SuperLeaf8/mobile-cardiac-sensor/README.md

# Mobile "Cardiac" Sensor
it does NOT detect a cardiac signature, it detects up to 3 human targets and tracks them as best as it can.

this works by using a radar "echo", kind of like ultrasonic except high frequency RF instead of ultrasonic sound waves. it tries its best to pick up flesh like objects like that and determine distances

if you built this correctly, you will see a radar type display with some text. targets will show up as differently colored dots
by default the range i set is 5m, each line in the circle is 1m
the bigger the dots are, the more you can suspect a cluster of people

do look at the [documentation](https://github.com/SuperLeaf8/mobile-cardiac-sensor/blob/main/457502695.pdf)

## hi, some things to note
1. if you want to make your own version with different parts or rewritten code (making it better or making it do different things) you can make forks, and do let me know i am very interested in seeing
2. this is using consumer grade electronics because i am a poor engineering student. the not so dependent quality is the irl nerf
3. i expect you to at least know how to connect wires together and use a computer. be a LITTLE tech savvy, i will try to explain how and why i do things
4. the 3d files are for if you are using the components i used EXACTLY. if not, you can use tinkercad to tinker with the 3d models.
5. if you have questions you can leave an issue with a question label

## materials
you will NEED the following:
- [RD03D sensor (the tracking thing)](https://a.co/d/0ip2m8Sf)
- [4" TFT screen (display)](https://a.co/d/0evdUtjt) or other 320x480 tft display, make sure it is ST7796S driven. otherwise youll have new wirings and new code to make
- [TXB/S0108 board](https://a.co/d/0fWlWtSx)
- [3.7v LiPo](https://a.co/d/0aEmB9fg)
- [charging board for battery](https://a.co/d/0h1k8oPG)
- a 5v microcontroller + programming board/cable. i am using the Arduino Pro Mini (5V, 16MHz) but i recommend an Arduino Nano if you dont mind using more space
- computer to upload program
### other matierals/tools you need not specific to the project
- soldering station (preferably a station, not those cheap cord ones). should come with solder wire and flux
- green prototype circuit boards with holes
- wires for the pcb

if you are NOT using a microcontroller that has 3.3v (arduino pro mini 5v for example), you will need the [3.3v regulator](https://a.co/d/0eNMOGoz)
if your board has a 3.3v regulator (like the nano) then use that instead

## how to make (the hardware)
i will upload a picture and link the circuit to refer to in order to build the hardware for this. i HIGHLY suggest soldering a circuit, and even more suggest getting a proper PCB from a vendor. soldering skills are a must

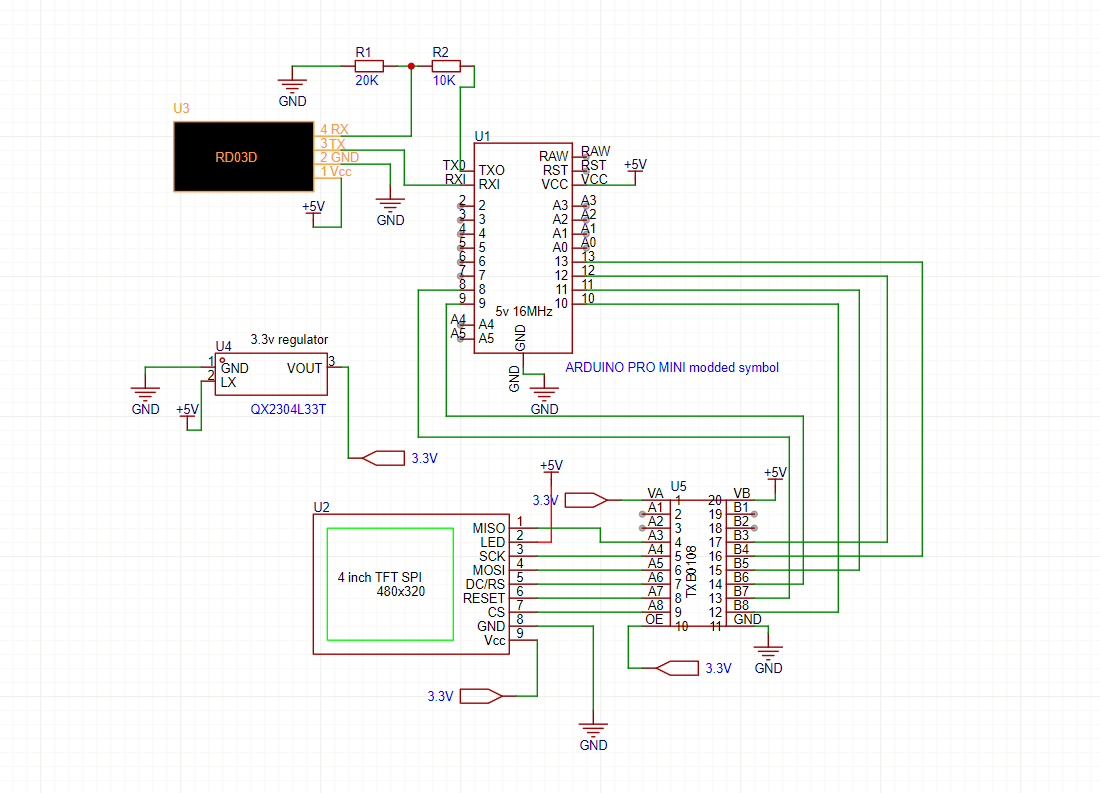
[picture p1: schematic.png]
schematic of circuit

### notes about hardware
- you will need to solder wires for the battery and the switch (which is what will power the project, i will draw a schematic of THAT later)
- you will also need to solder wires onto the sensor, they are not through-hole pads.
- the TXB0108 is a MUST because otherwise you will fry the screen
- the two little resistors is also a must so you dont fry the radar. the values do not matter as long as they are large and the one on the left is 2 times larger
- a multimeter is a good tool to have to check for connections or unwanted connections
- im not using the touch function of the TFT display, so i leave those pins unconnected. if you want some touch functionality there should be enough pins on an Arduino mini/nano to do it
- 3d files: the holes are m2 and m3 screws. orient them to print them, you need SOME density and supports. the "radar slot" may not fit completely and may need some spacers (m2).
- the battery charger board i have linked does the following:
  - convert a 1s lipo (3.7) voltage to 5 volts
  - when charging with a usb c, the battery charges and still maintains its output
  - green flashing means charging, fully green means full, blue means output draw (being used), no light means standby
  - with a 7Wh battery your shit should last like 240 hours on standby
  - it has undervoltage and overcurrent protection (3v undervoltage, 3A overcurrent)

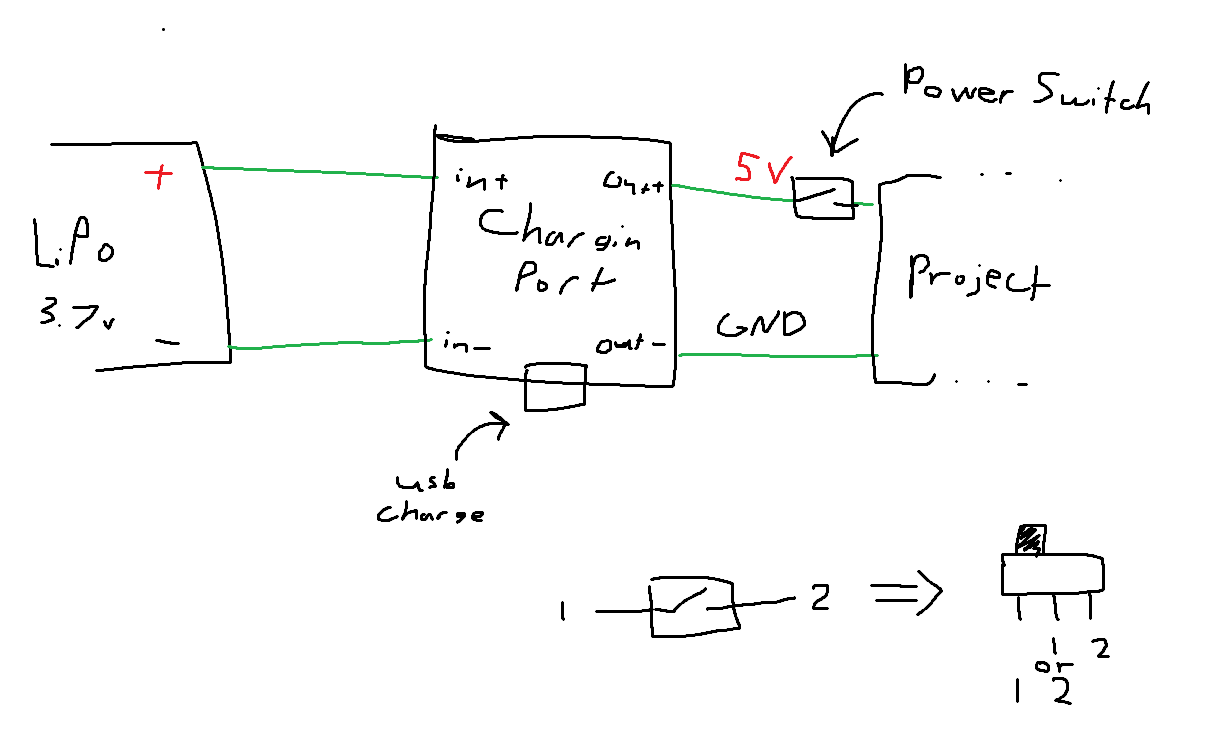
[picture p2: battery.png]
battery diagram with switch


## how to make (the software)
- make sure you can get the Arduino IDE installed and proper (Linux user will need to mess with permissions for ports on /dev/ttyXX)
- install the [Adafruit GFX Library](https://github.com/adafruit/adafruit-gfx-library) and the [ST7796S driver for it](https://github.com/prenticedavid/Adafruit_ST7796S_kbv). you will need to learn how to install these libraries
- copy my code or download it, it should be a folder named `heartbeatsensor` with another file `heartbeatsensor.ino` inside
- upload the code. it is VITAL that you unplug the RD03D pins (RX, TX) from the Arduino before you upload it. plug it in after
- the IDE will tell you if there are any problems

## what else
make your own chasis and whatnot for the project. i am not liable if something blows up. issues or anything pls leave a github issue

credits: Adafruit for the base gfx library, skrunkgy for core parts of the front code, and prenticedavid and contributors for the driver code for this specific display.
