SuperLeaf8/mobile-cardiac-sensor/mobile_cardiac3d/Panel 1 - Part 1.stl

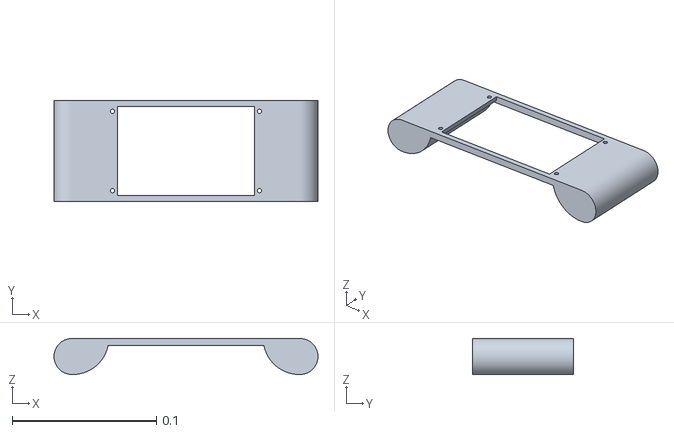
[picture p4: CAD file, 2026-10-11]
mobile_cardiac3d/Panel 1 - Part 1.stl
0.183 x 0.07 x 0.025
