SuperLeaf8/mobile-cardiac-sensor/cardiac_files/Panel 3.stl

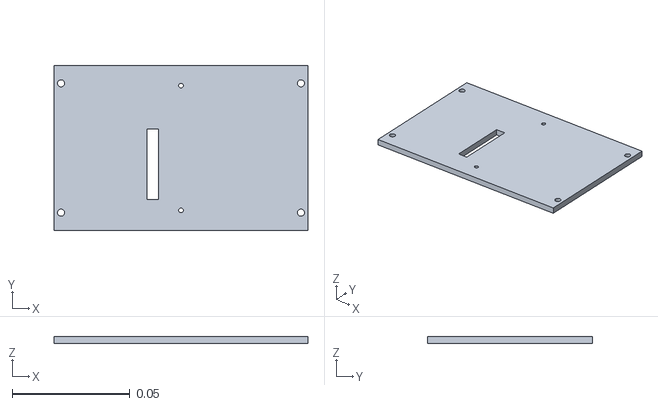
[picture p5: CAD file, 2026-10-14]
cardiac_files/Panel 3.stl
0.108 x 0.07 x 0.003
