SuperLeaf8/mobile-cardiac-sensor/mobile_cardiac3d/Radar slot - Part 1.stl

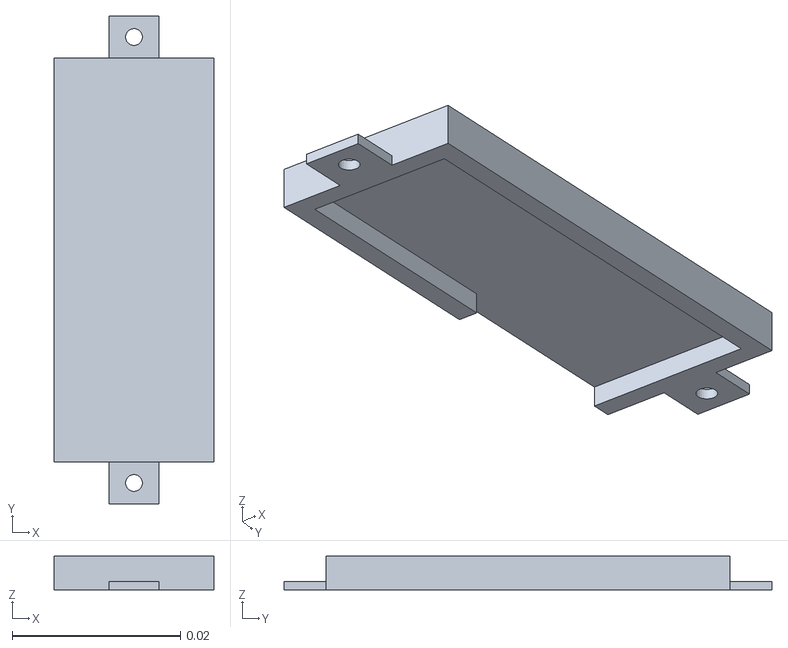
[picture p6: CAD file, 2026-10-11]
mobile_cardiac3d/Radar slot - Part 1.stl
0.019 x 0.058 x 0.004
