SuperLeaf8/mobile-cardiac-sensor/cardiac_files/Radar slot.stl

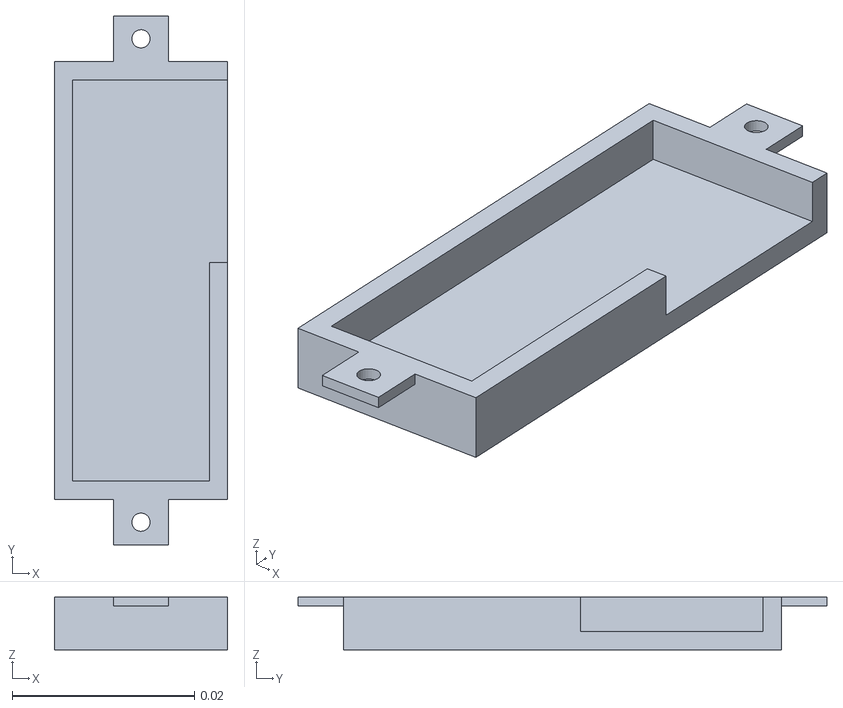
[picture p7: CAD file, 2026-10-14]
cardiac_files/Radar slot.stl
0.019 x 0.058 x 0.0058
