SuperLeaf8/mobile-cardiac-sensor/(list of files, cad)

Other CAD files:
cardiac_files/Panel 1.stl
mobile_cardiac3d/Panel 2 - Part 1.stl
