SuperLeaf8/mobile-cardiac-sensor/cardiac_files/MobileCardiac.pdf

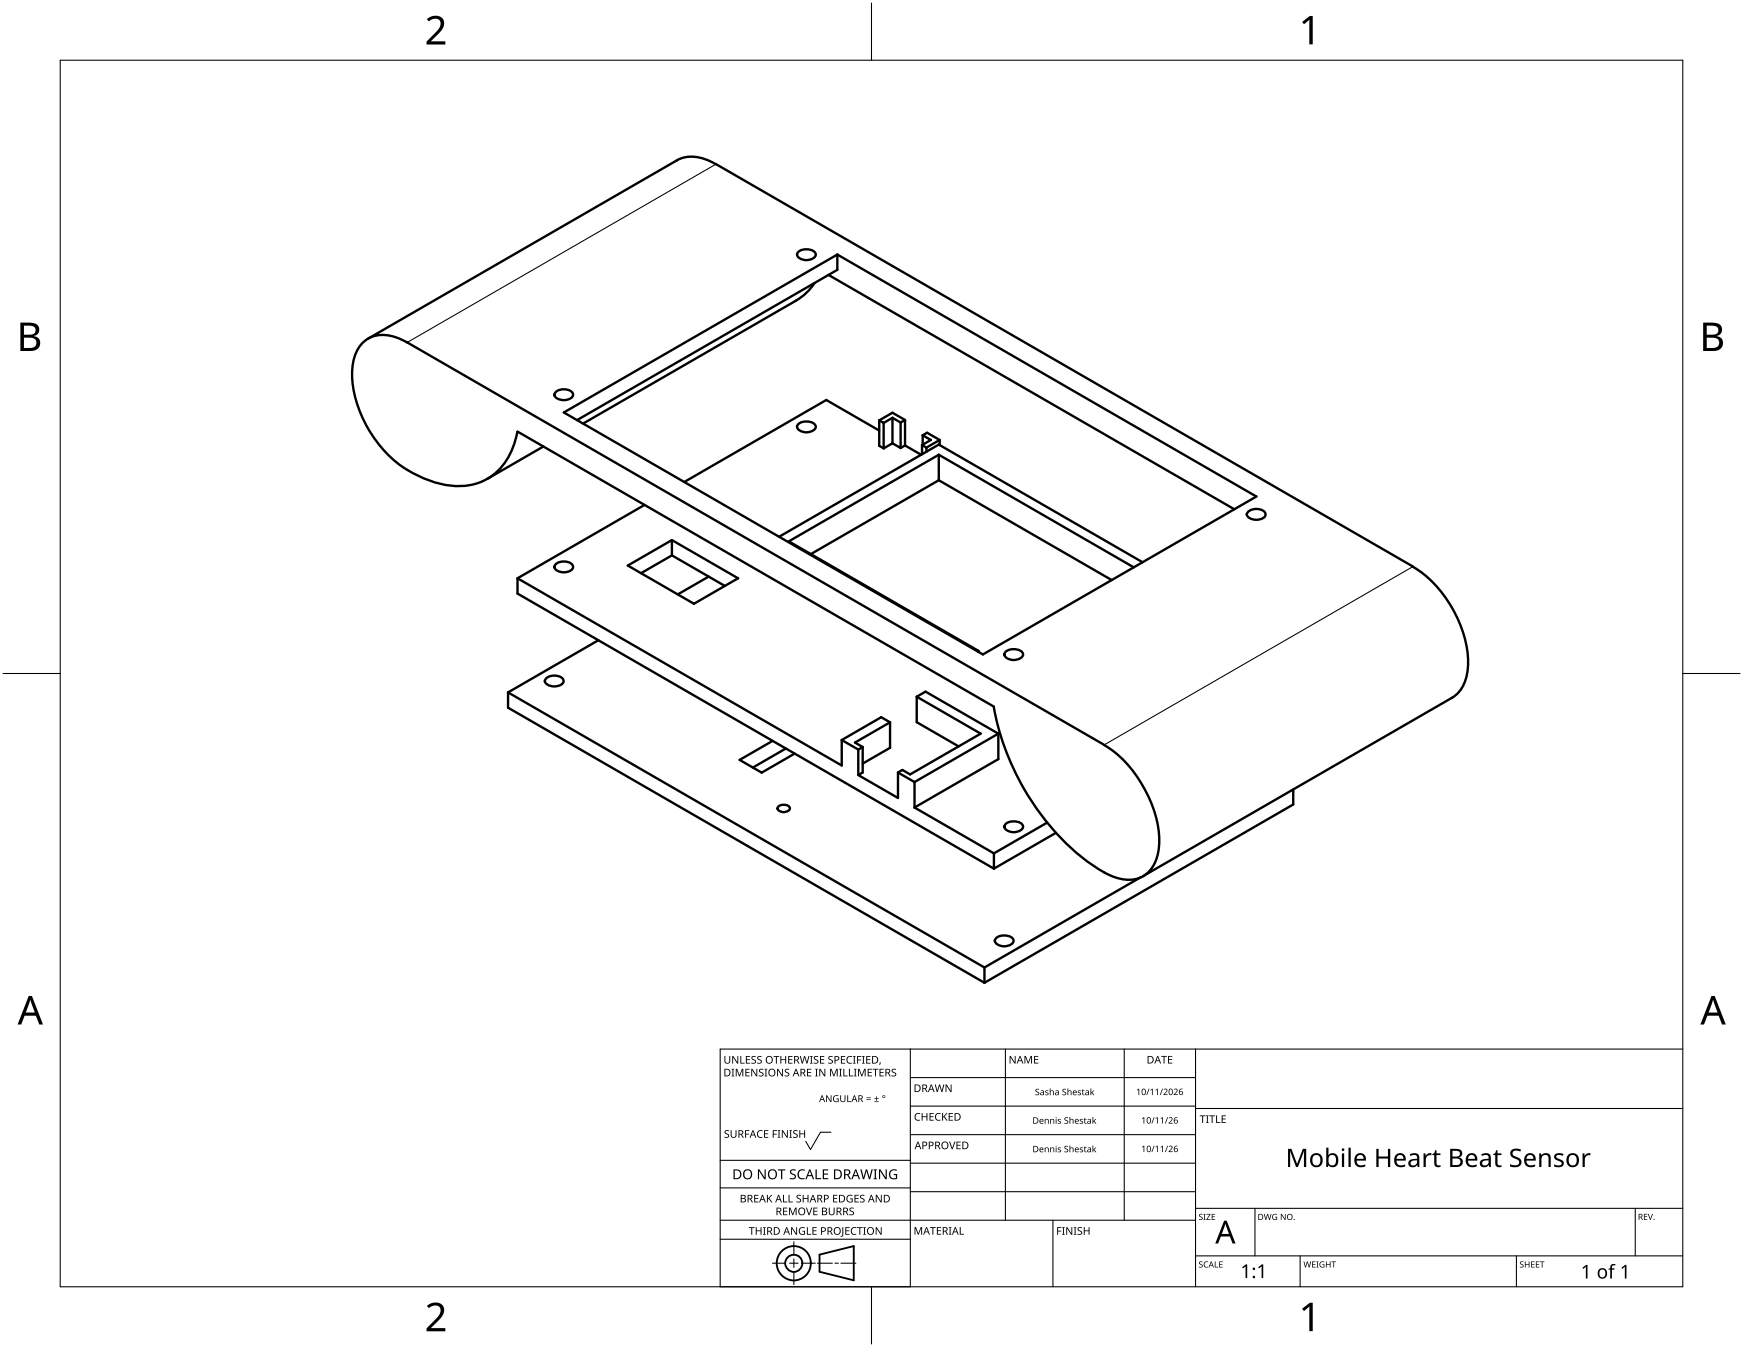
[picture p8: page 1]

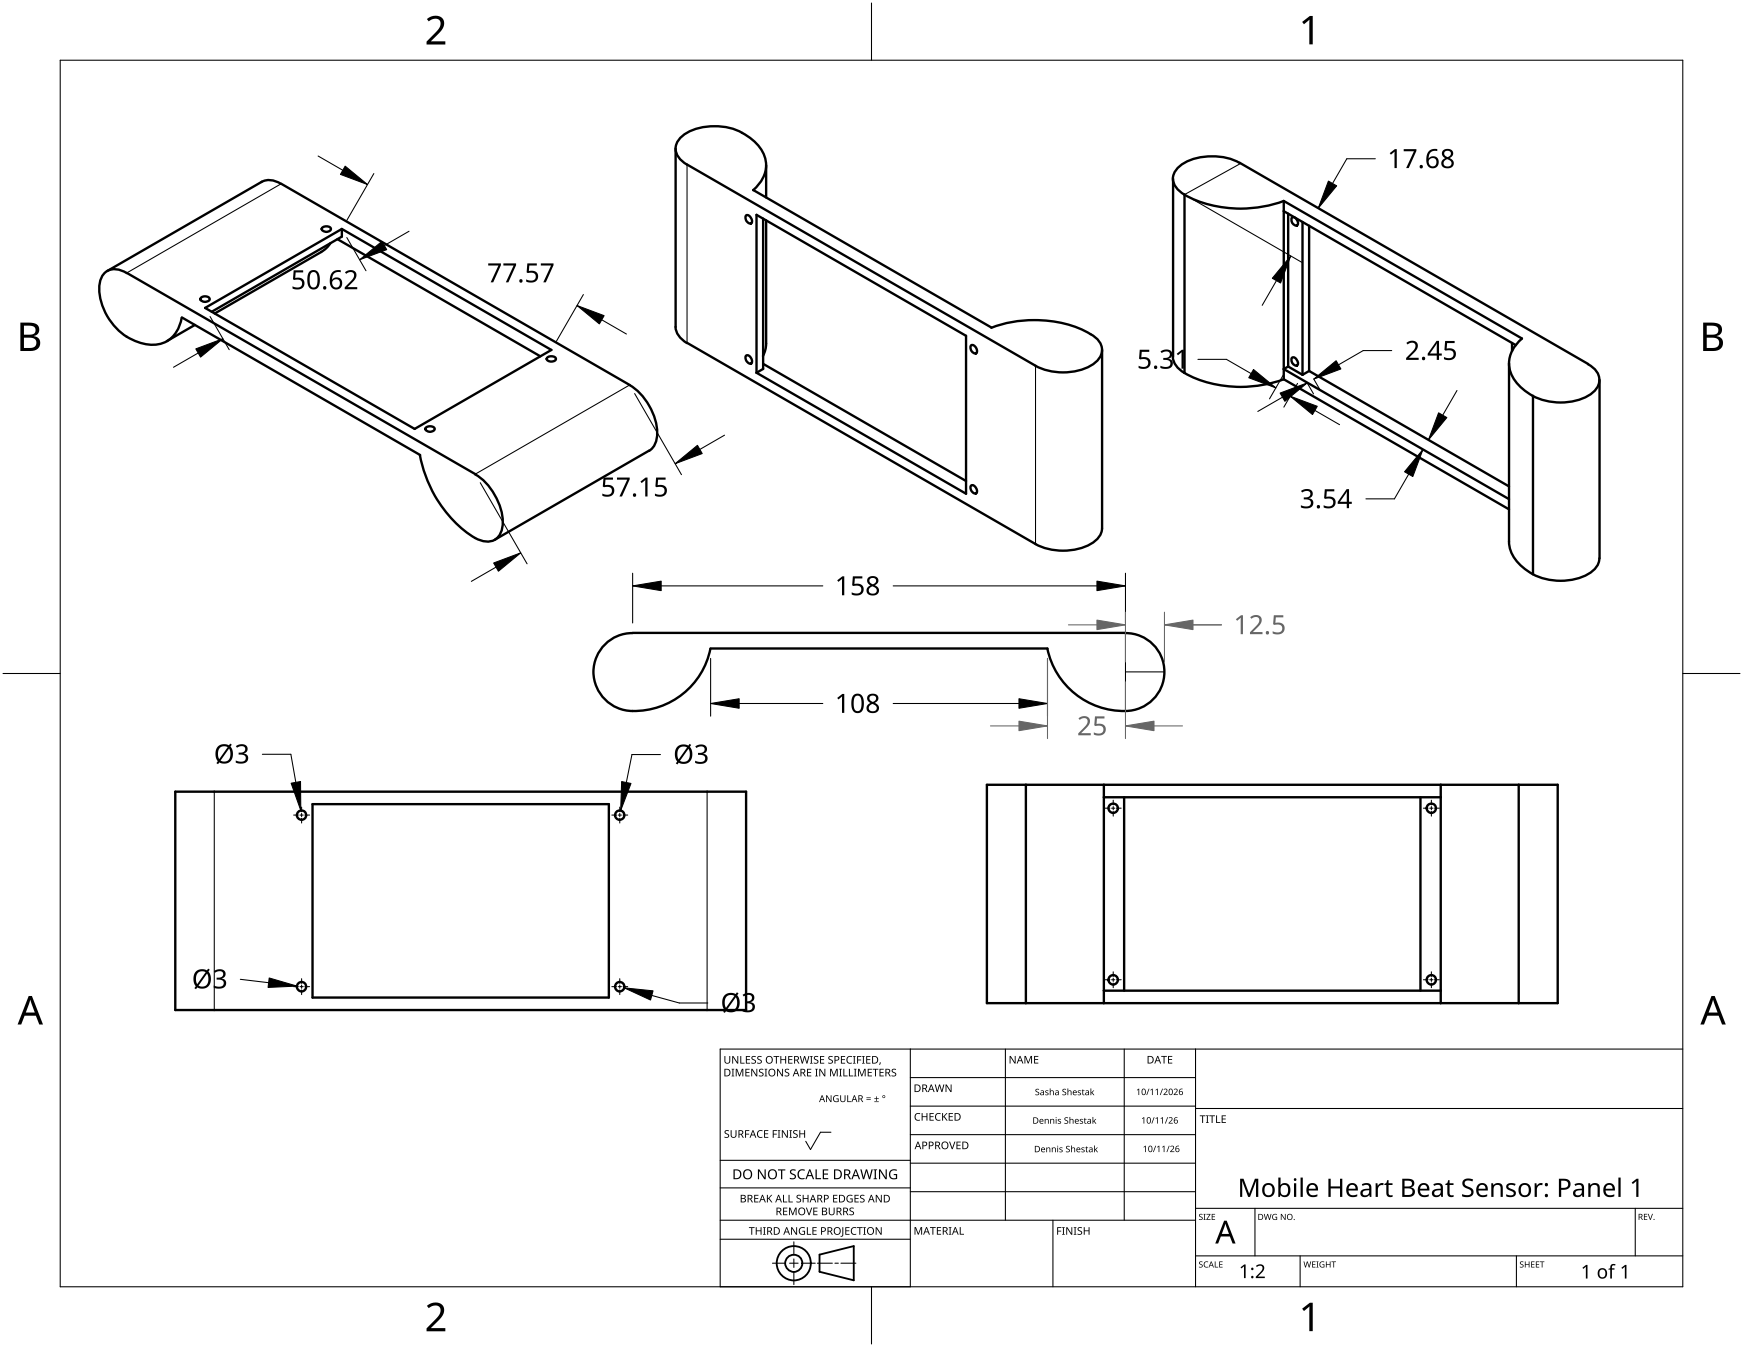
[picture p9: page 2]

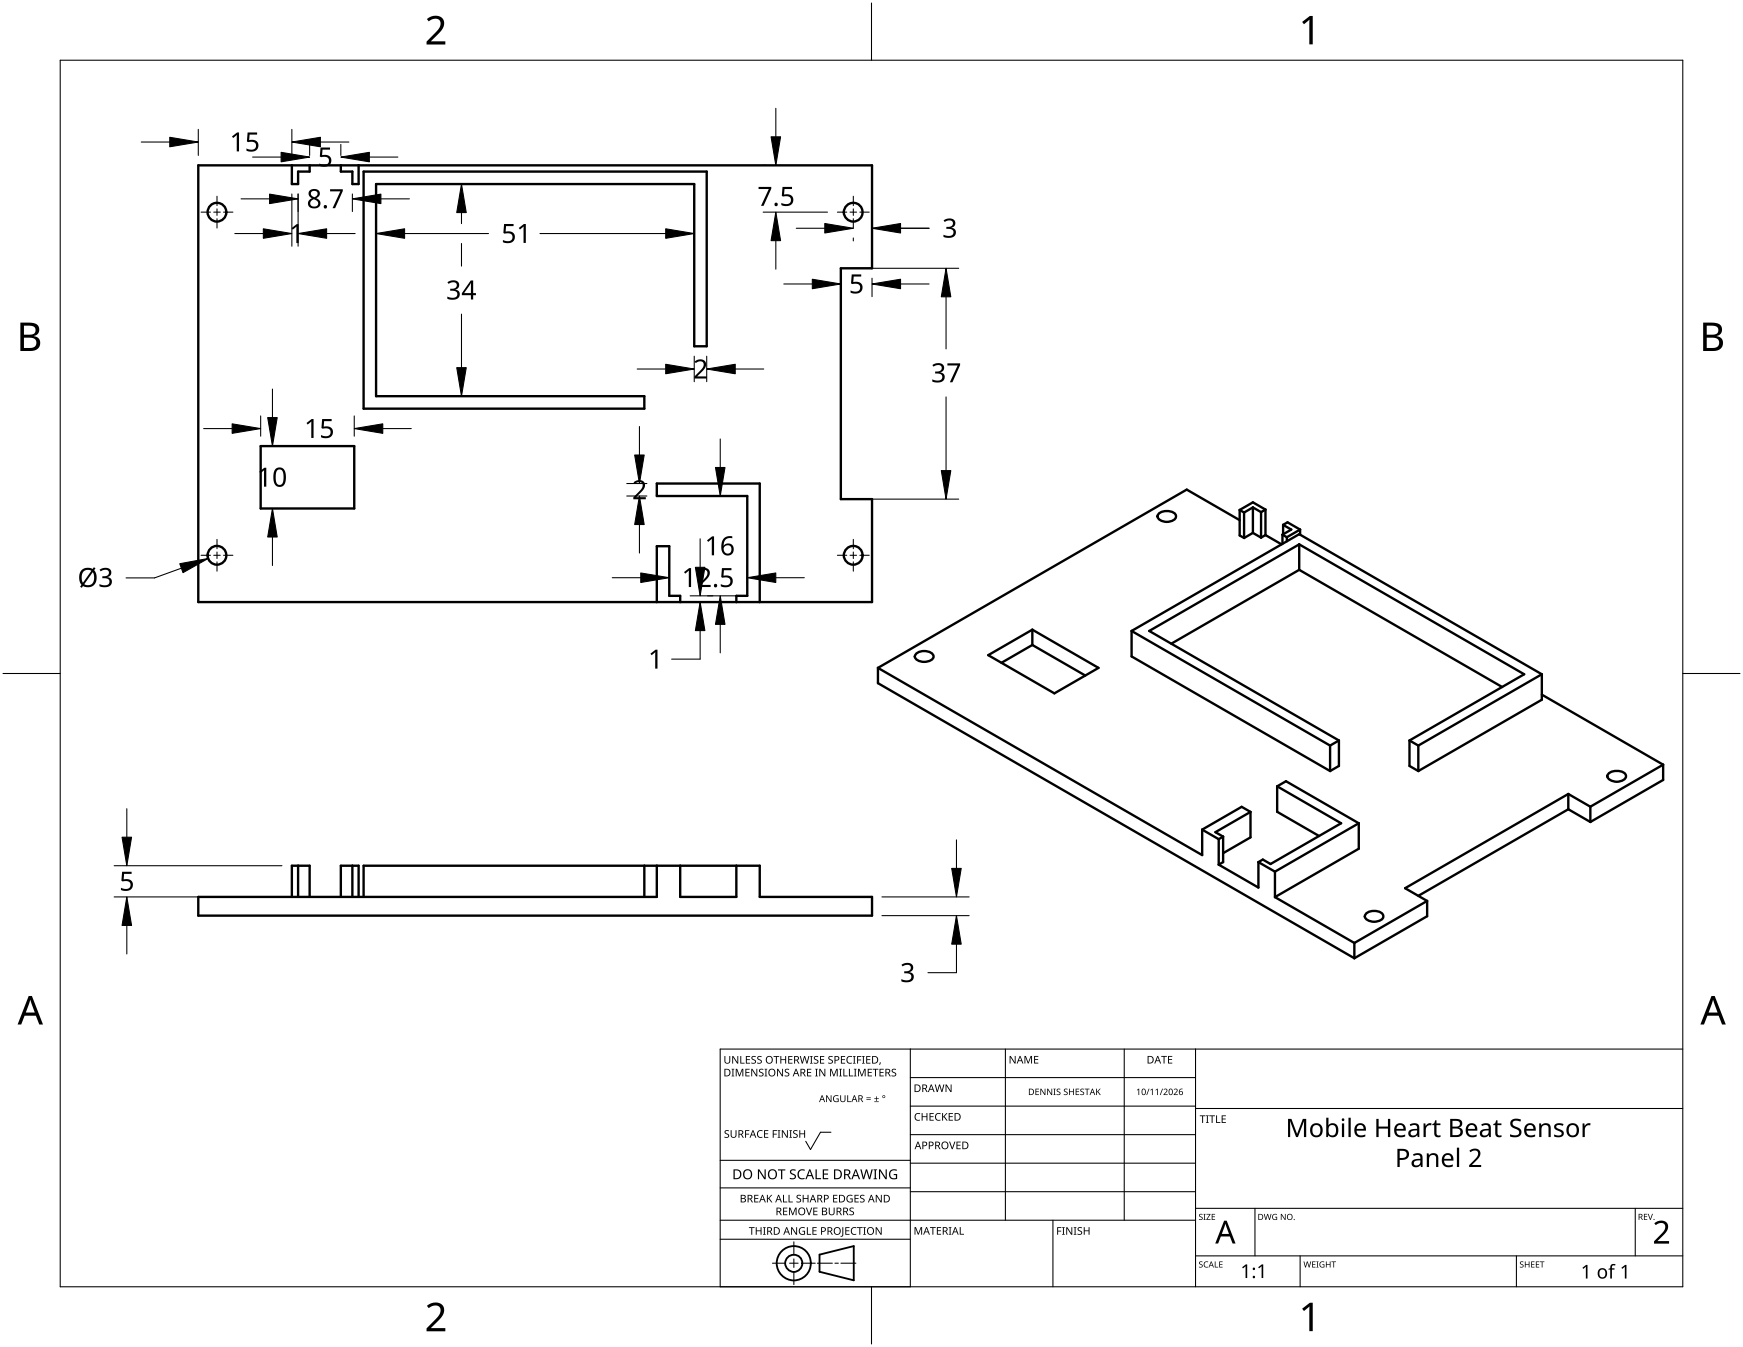
[picture p10: page 3]

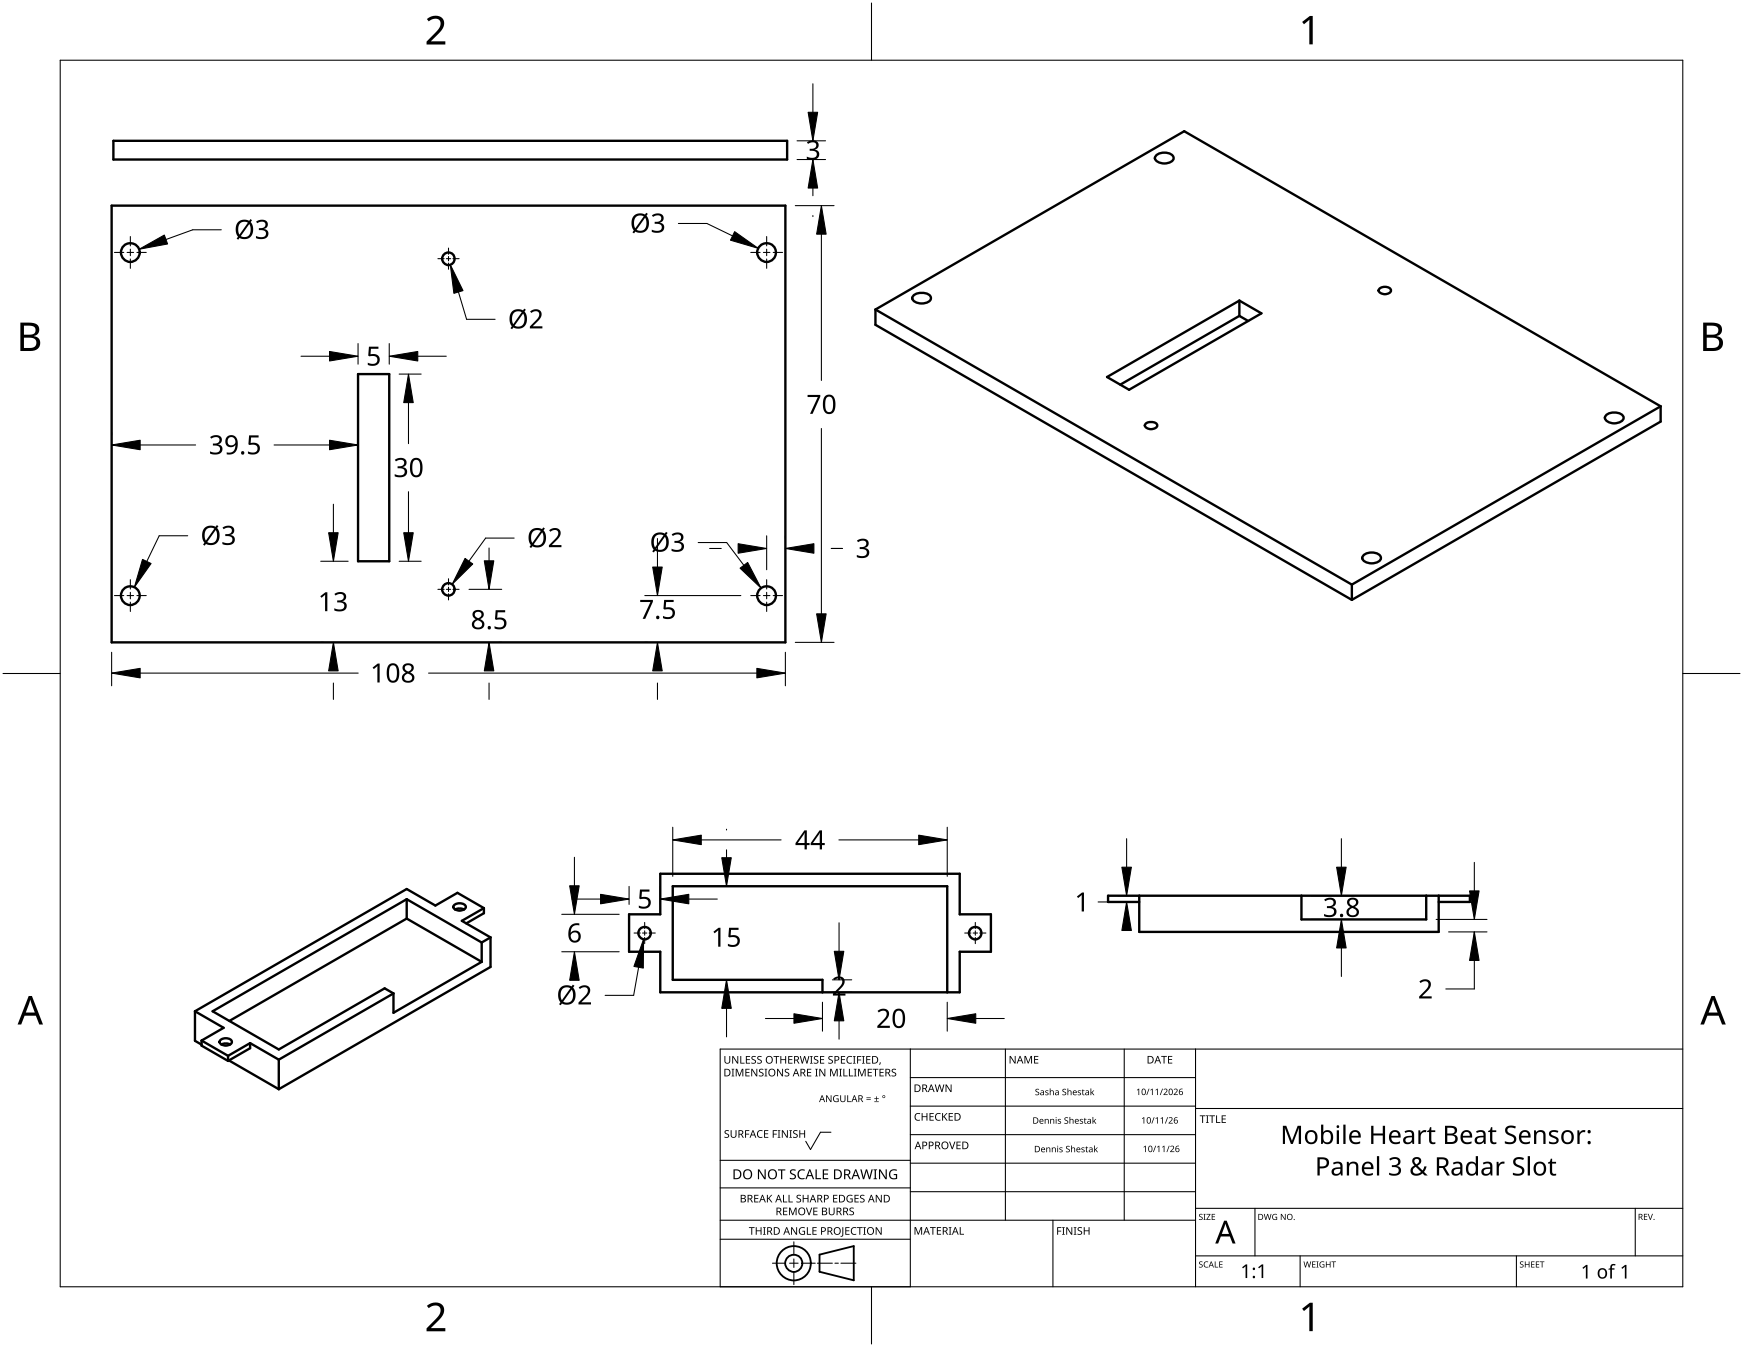
[picture p11: page 4]
