SuperLeaf8/mobile-cardiac-sensor/(commit log)

2026-09-09 updated materials
2026-09-09 board
    readme of charging board
2026-10-11 added 3d files
    THANK YOU TO MY SISTER FOR HELP WITH DESIGNING 3D FILES IN CAD!!!!
2026-10-14 updated files, included gerber
    unfortunately i will have to close the repo soon
